Izzudinwahid/PT.MGI-DAS-POWER/DAS POWER/List Komponen Das Power.xlsx

KEPERLUAN DAS POWER UNTUK 1 UNIT
No | Nama Komponen | jumlah | Harga | ongkir | Total | keterangan | Link
1 | usb micro Connector | 2 | Rp 500 | Rp 7000 | Rp 8000 | Komponen yang sudah embbed di china(TIDAK PERLU DIORDER) | https://www.tokopedia.com/best-ay/micro-usb-5-pin-female-soket-socket-mk5p-5pin-connector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
2 | ch340g | 1 | Rp 6000 | Rp 7000 | Rp 13000 |  | https://www.tokopedia.com/isee/ic-ch340-ch340g-usb-serial-ttl-uart-rs232-chip-ch-340-sop-16-sop16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
3 | resistor 10k 0805 | 10 | Rp 100 |  | Rp 1000 |  | https://www.tokopedia.com/isee/resistor-smd-0805-10k-10-k-kilo-ohm-10000-ohm-toleransi-1-tolerance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
4 | ams1117 3.3V | 2 | Rp 1000 |  | Rp 2000 |  | https://www.tokopedia.com/isee/ams1117-3-3v-smd-regulator-sot-223?extParam=whid%3D318325
5 | resistor 330 0805 | 8 | Rp 100 |  | Rp 800 |  | https://www.tokopedia.com/isee/resistor-smd-0805-330ohm-330-ohm-toleransi-1-tolerance-1?extParam=whid%3D318325
6 | led SMD hijau | 3 | Rp 1000 |  | Rp 3000 |  | https://www.tokopedia.com/isee/10x-led-smd-0805-hb19-super-bright-2hb0756-terang-warna-hijau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
7 | crystal 12Mhz smd | 1 | Rp 3050 | Rp 7000 | Rp 10050 |  | https://www.tokopedia.com/digiware/12mhz-crystal-xtal-oscillator-osilator-low-profile-smd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
8 | capasitor 22pF 0805 | 5 | Rp 220 |  | Rp 1100 |  | https://www.tokopedia.com/digiware/22pf-50v-5-capacitor-kapasitor-smd-0805?extParam=whid%3D264299
9 | capasitor 1uF 0805 | 8 | Rp 300 | Rp 16000 | Rp 18400 |  | https://www.tokopedia.com/putraniagabdg/kapasitor-smd-0805-1uf-50v-capacitor-non-polar-105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
10 | capasitor elco 10uF/16V | 2 | Rp 800 |  | Rp 1600 |  | https://www.tokopedia.com/putraniagabdg/elco-smd-10uf-16v-alumunium-10-uf-16volt-aluminum-kapasitor-4x5-mm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
11 | resistor 100 ohm 0805 | 10 | Rp 1000 |  | Rp 10000 |  | https://www.tokopedia.com/putraniagabdg/10pcs-resistor-smd-0805-100r-tahanan-100-ohm-100ohm-marking-101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
12 | resistor 160 ohm 0805 | 10 | Rp 3000 | Rp 13000 | Rp 43000 |  | https://www.tokopedia.com/indo-ware/160r-160-ohm-0805-5-paket-10-pcs-resistor-smd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
13 | capasitor 100nF 0805 | 8 | Rp 600 |  | Rp 4800 |  | https://www.tokopedia.com/indo-ware/0805-104-100nf-100nf-50v-kapasitor-2012-104k-smd-kapasitor-capasitor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
14 | diode zener 3v3 smd | 8 | Rp 500 |  | Rp 4000 |  | https://www.tokopedia.com/indo-ware/33v-dioda-zener-05w-diode-3v3-33v-33-33-v-12w-12-05-05-w-smd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
15 | transistor MMBT3904 | 5 | Rp 100 | Rp 12000 | Rp 12500 |  | https://www.tokopedia.com/lisuinstrument/mmbt3904-3904-1am-2n3904-npn-general-purpose-transistor-sot-23-generic-biasa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
16 | schottky 1N5819 | 5 | Rp 200 |  | Rp 1000 |  | https://www.tokopedia.com/lisuinstrument/1n5819-sma-ss14-smd-1-0a-schottky-barrier-rectifier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
17 | TTL ke RS485 | 3 | Rp 15000 | Rp 7000 | Rp 52000 |  | https://www.tokopedia.com/akhishop/uart-ttl-to-rs485-module-two-way-converter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
18 | mini 560 5V | 1 | Rp 15000 |  | Rp 15000 |  | https://www.tokopedia.com/akhishop/dc-dc-mini560-5a-dc-stepdown-regulated-power-supply-module-5v
19 | mini W5500 | 1 | Rp 80000 |  | Rp 80000 |  | https://www.tokopedia.com/akhishop/mini-w5500-spi-to-lan-module?extParam=ivf%3Dfalse%26src%3Dsearch
20 | pzem 017 DC | 3 | Rp 150000 |  | Rp 450000 |  | https://www.tokopedia.com/akhishop/pzem-017-0-300v-rs485-modbus-dc-meter-current-voltage-power-energy-50a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
21 | ADS1115 | 3 | Rp 80000 |  | Rp 240000 |  | https://www.tokopedia.com/akhishop/ads1115-16-bit-adc-4-channel-with-programmable-gain-amplifier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
22 | lcd 20x4 i2c | 1 | Rp 70000 |  | Rp 70000 | beli 1 untuk ujicoba | https://www.tokopedia.com/akhishop/lcd-20x4-green-backlight-with-i2c-module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
23 | terminal block hijau 6p | 2 | Rp 9600 | Rp 20000 | Rp 39200 |  | https://www.tokopedia.com/s3-satriasecure/l-siku-pluggable-6-p-pin-terminal-blok-6p-6pin-screw-plugable-block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
24 | terminal block hijau 2p | 6 | Rp 3600 |  | Rp 21600 |  | https://www.tokopedia.com/s3-satriasecure/l-siku-pluggable-2-p-pin-5-08-terminal-2p-2pin-screw-plug-able-pcb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
25 | terminal block hijau 9p | 1 | Rp 12700 |  | Rp 12700 |  | https://www.tokopedia.com/s3-satriasecure/l-siku-pluggable-9-p-pin-terminal-blok-9p-9pin-screw-plugable-block
26 | push button L | 2 |  |  | Rp 0
27 | ESP32ESP32-WROOM-32D | 1 | Rp 39000 | Rp 21000 | Rp 60000 | TIDAK PERLU DIORDER | https://www.tokopedia.com/sagaladijualcorp/new-version-esp32-wroom-32d-wi-fi-bt-ble-32mbits-4mb-flash-espressif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
28 | adaptor 12v 2A | 1 | Rp 21000 | Rp 7000 | Rp 28000 |  | https://www.tokopedia.com/pusataccgadget/adaptor-charger-cctv-12v-2a-harga-khusus-dus-satuan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
29 | kabel serabut warna Merah | 1 | Rp 1200 | Rp 10000 | Rp 11200 |  | https://www.tokopedia.com/mulsanne/eceran-per-meter-kabel-tunggal-serabut-putih-merah?extParam=whid%3D3990461
30 | kabel serabut warna hitam | 1 | Rp 1200 |  | Rp 1200 |  | https://www.tokopedia.com/mulsanne/eceran-per-meter-kabel-tunggal-serabut-putih-hitam?extParam=whid%3D3990461
31 | kabel serabut warna hijau | 1 | Rp 1200 |  | Rp 1200 |  | https://www.tokopedia.com/mulsanne/eceran-per-meter-kabel-tunggal-serabut-putih-hijau-muda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
32 | kabel serabut warna kuning | 1 | Rp 1200 |  | Rp 1200 |  | https://www.tokopedia.com/mulsanne/eceran-per-meter-kabel-tunggal-serabut-putih-kuning?extParam=whid%3D3990461
33 | konektor xh 4pin | 2 | Rp 1600 | Rp 7000 | Rp 10200 |  | https://www.tokopedia.com/gst-21/konektor-molex-2-3-4-5-6-pin-soket-socket-molek-pitch-2-5-ph-jst-xh-4-pin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
34 | hall efect sensor for DC current measuring 100A | 3 | Rp 440000 | Rp 25000 | Rp 1345000 | Beli 3 dan Segera diorder karena pre-order | https://www.tokopedia.com/fadalstore/ankerui-ahkc-eka-0-100-a-5v-20-hall-open-type-current-sensor
35 | Oled i2c | 1 | Rp 38000 | Rp 10000 | Rp 48000 | beli 1 untuk ujicoba | https://www.tokopedia.com/hwthinker/modul-display-oled-128x64-lcd-i2c-0-96-inch-arduino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
TOTAL |  |  |  |  | Rp 2620750
Note:
1. Belum Termasuk PCB
2. Belum Termasuk Box
Penjelasan Warna:
 | segera diorder
 | Komponen Embbed di China
