Izzudinwahid/PT.MGI-DAS-POWER/DAS POWER/PCB/untitled.pdf

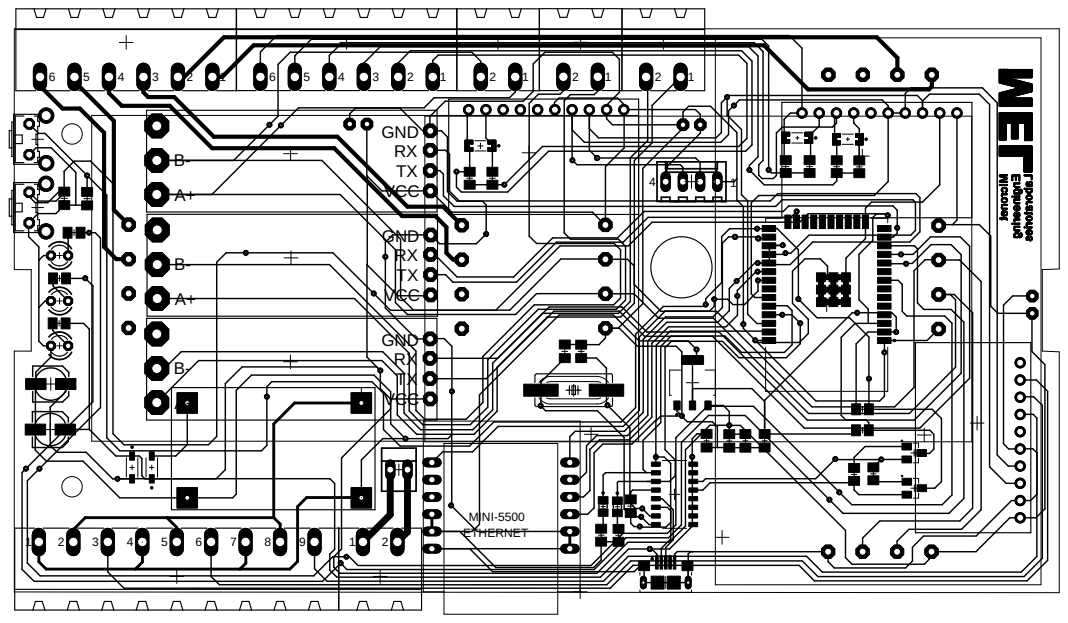
[picture p1: page 1]
