Izzudinwahid/PT.MGI-DAS-POWER/DAS POWER/PCB/untitled.brd

## EAGLE design DAS POWER/PCB/untitled.brd (2023-05-26)

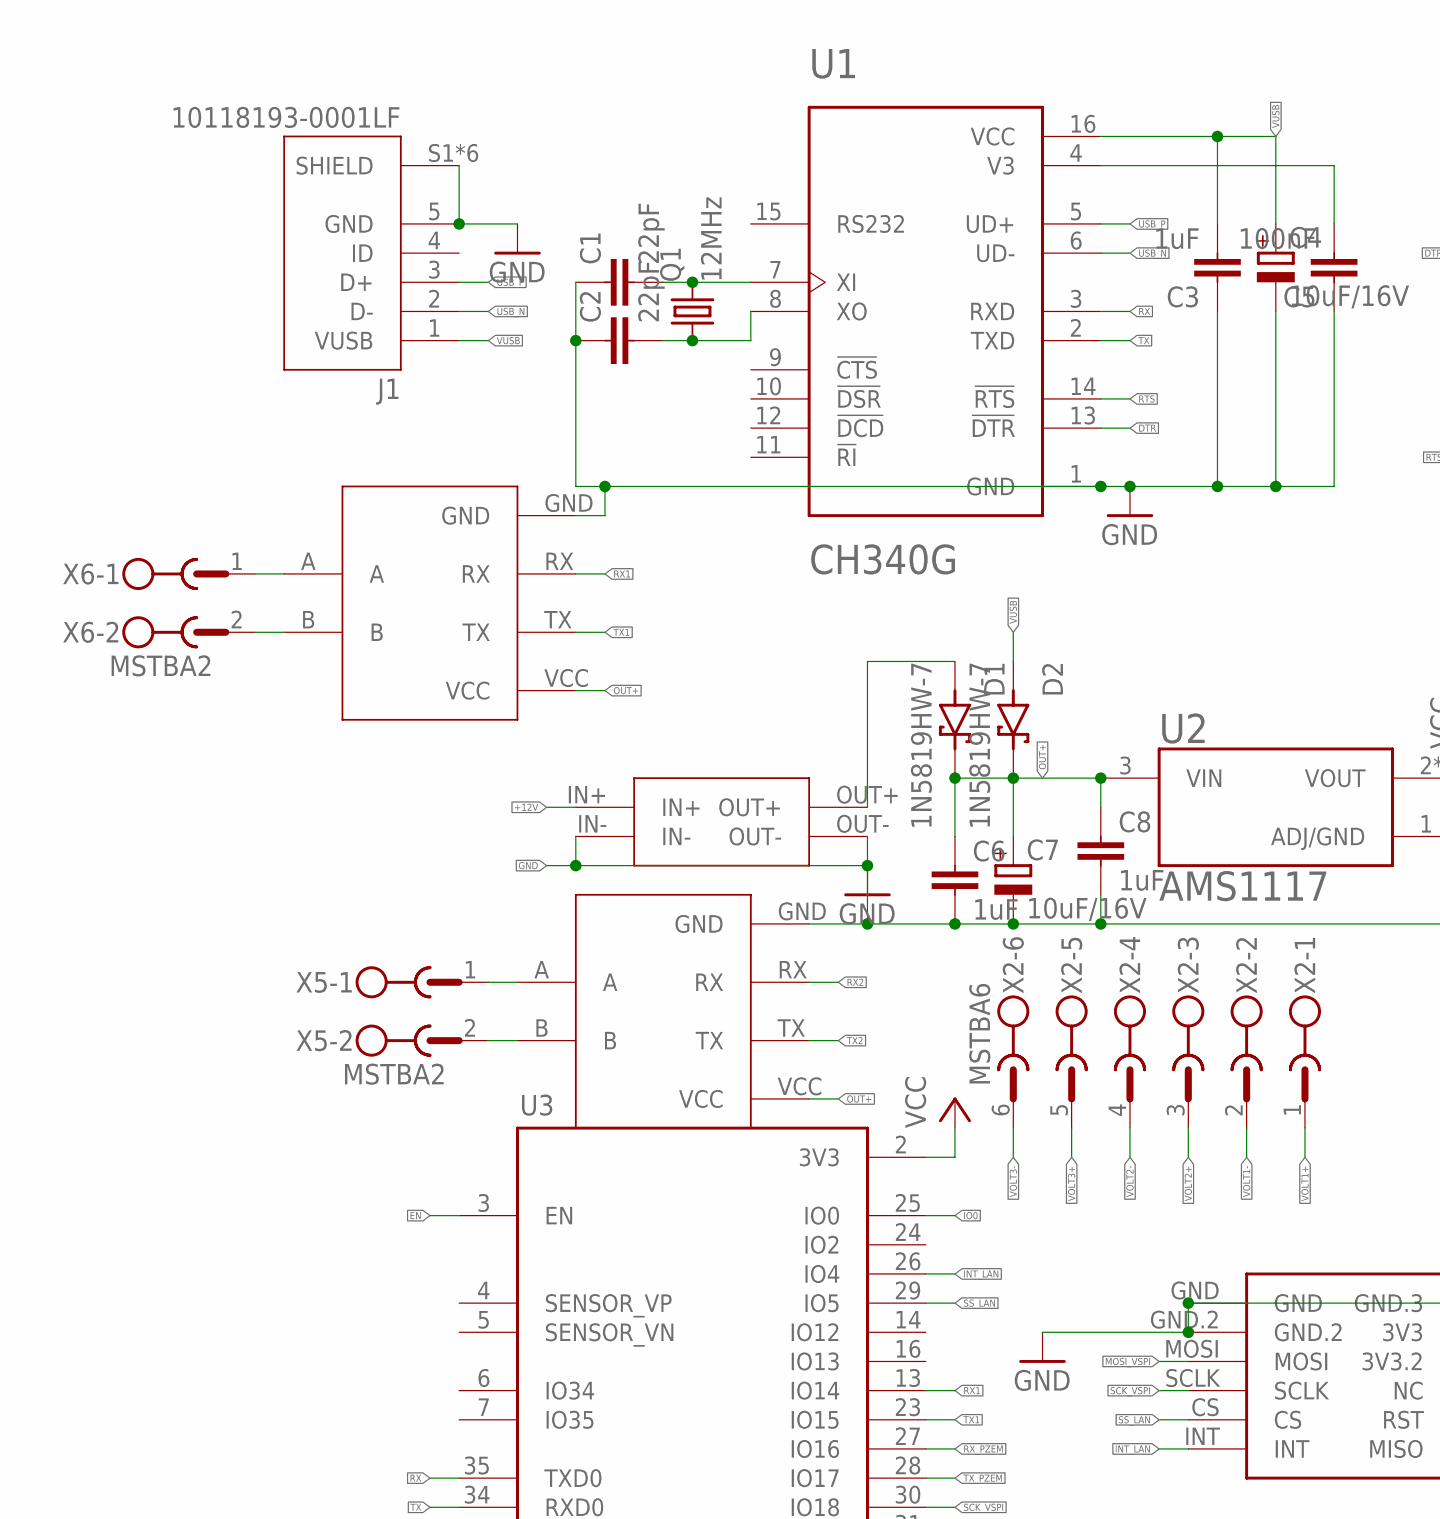
[picture p2: schematic untitled.sch, part in row 1, column 1]

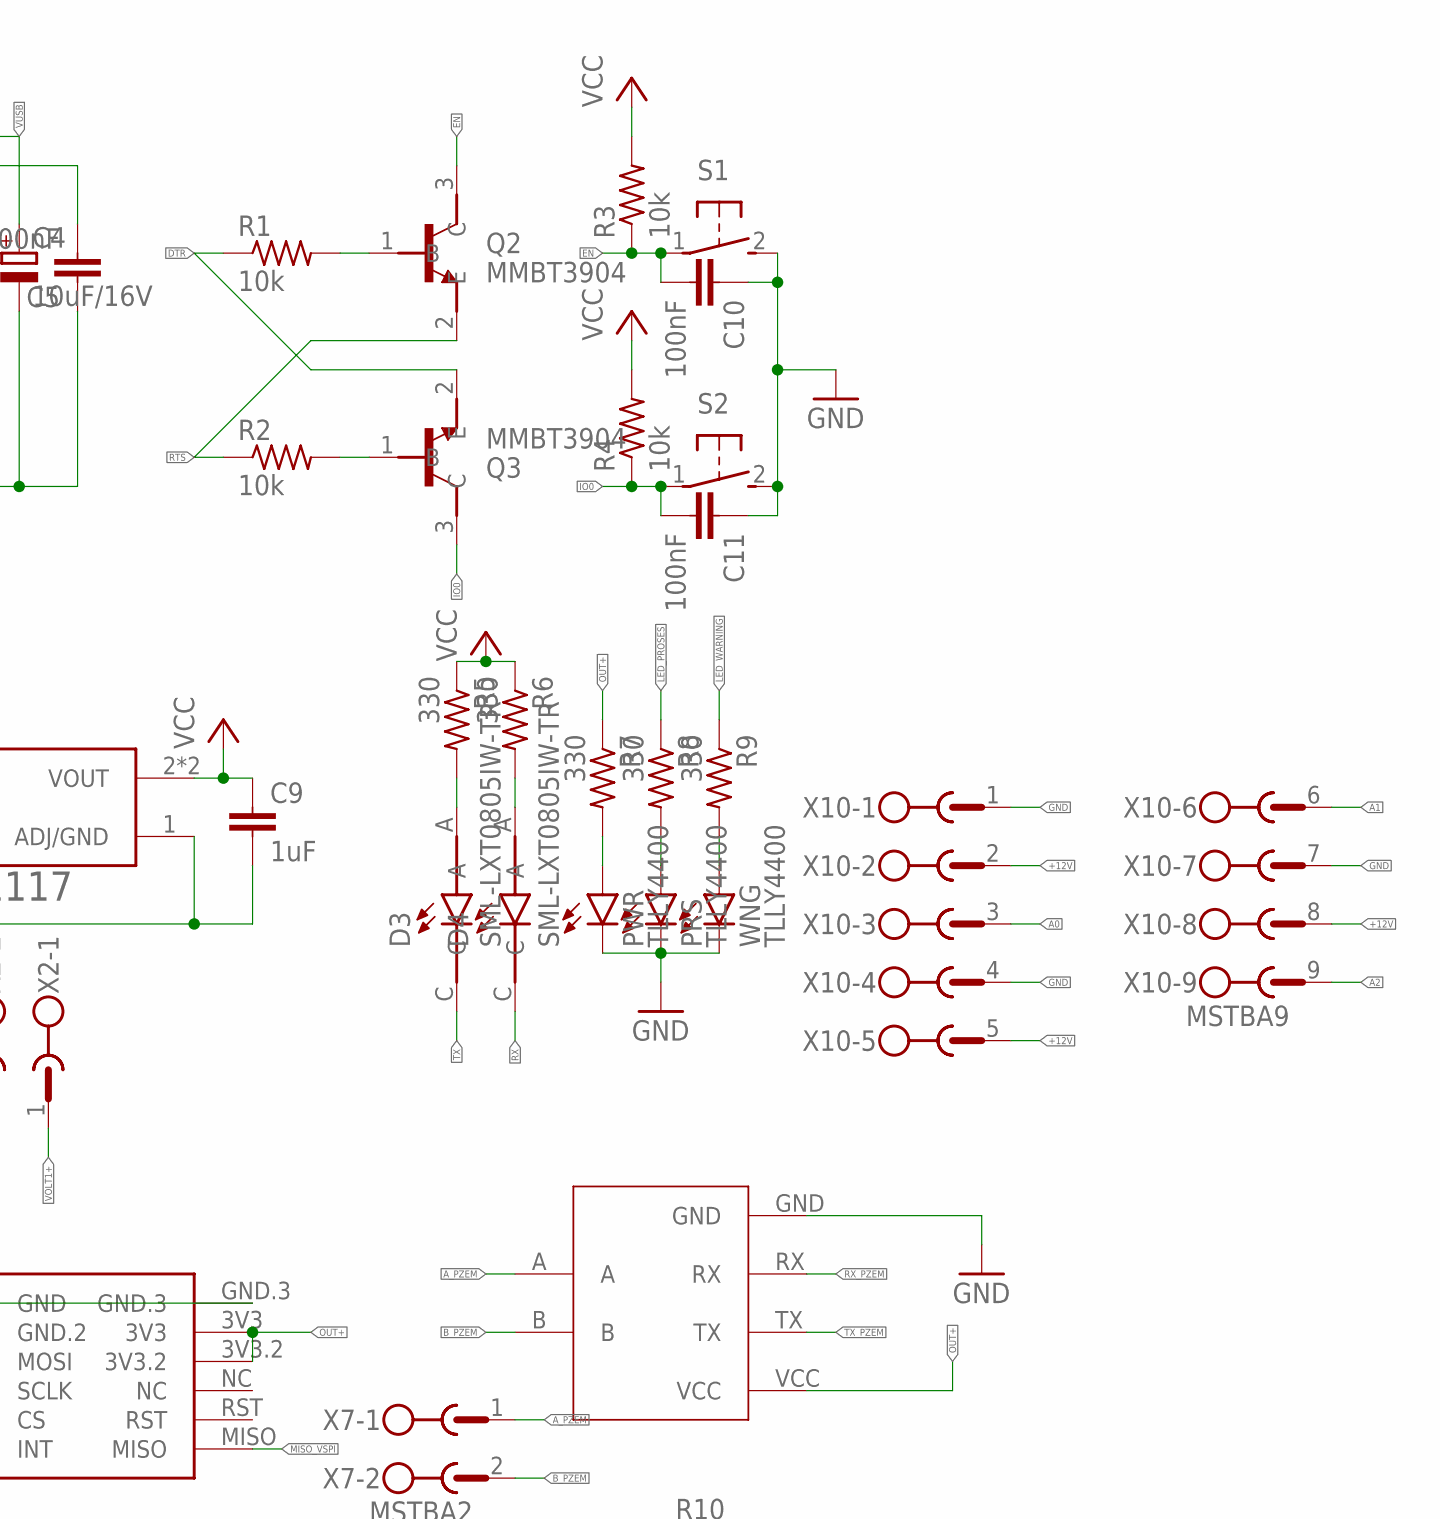
[picture p3: schematic untitled.sch, part in row 1, column 2]

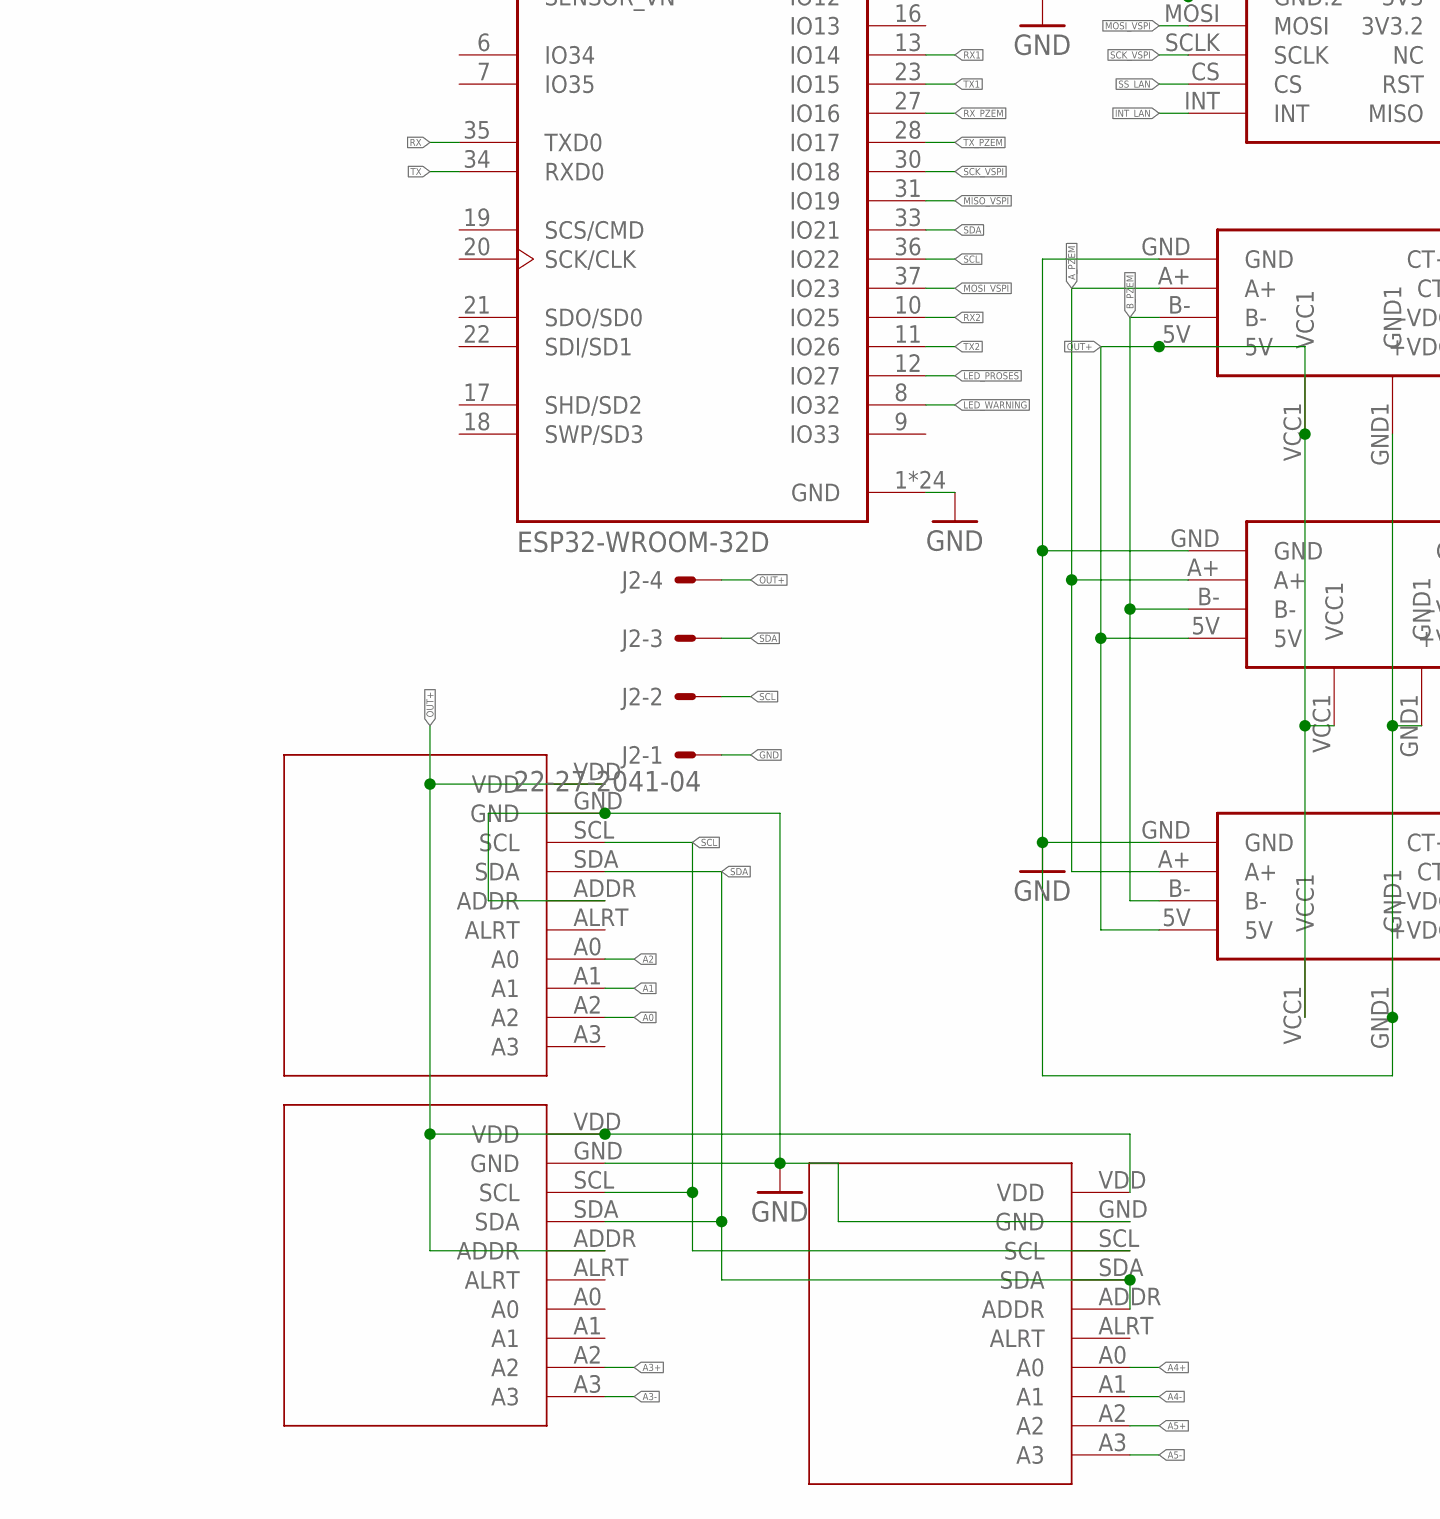
[picture p4: schematic untitled.sch, part in row 2, column 1]

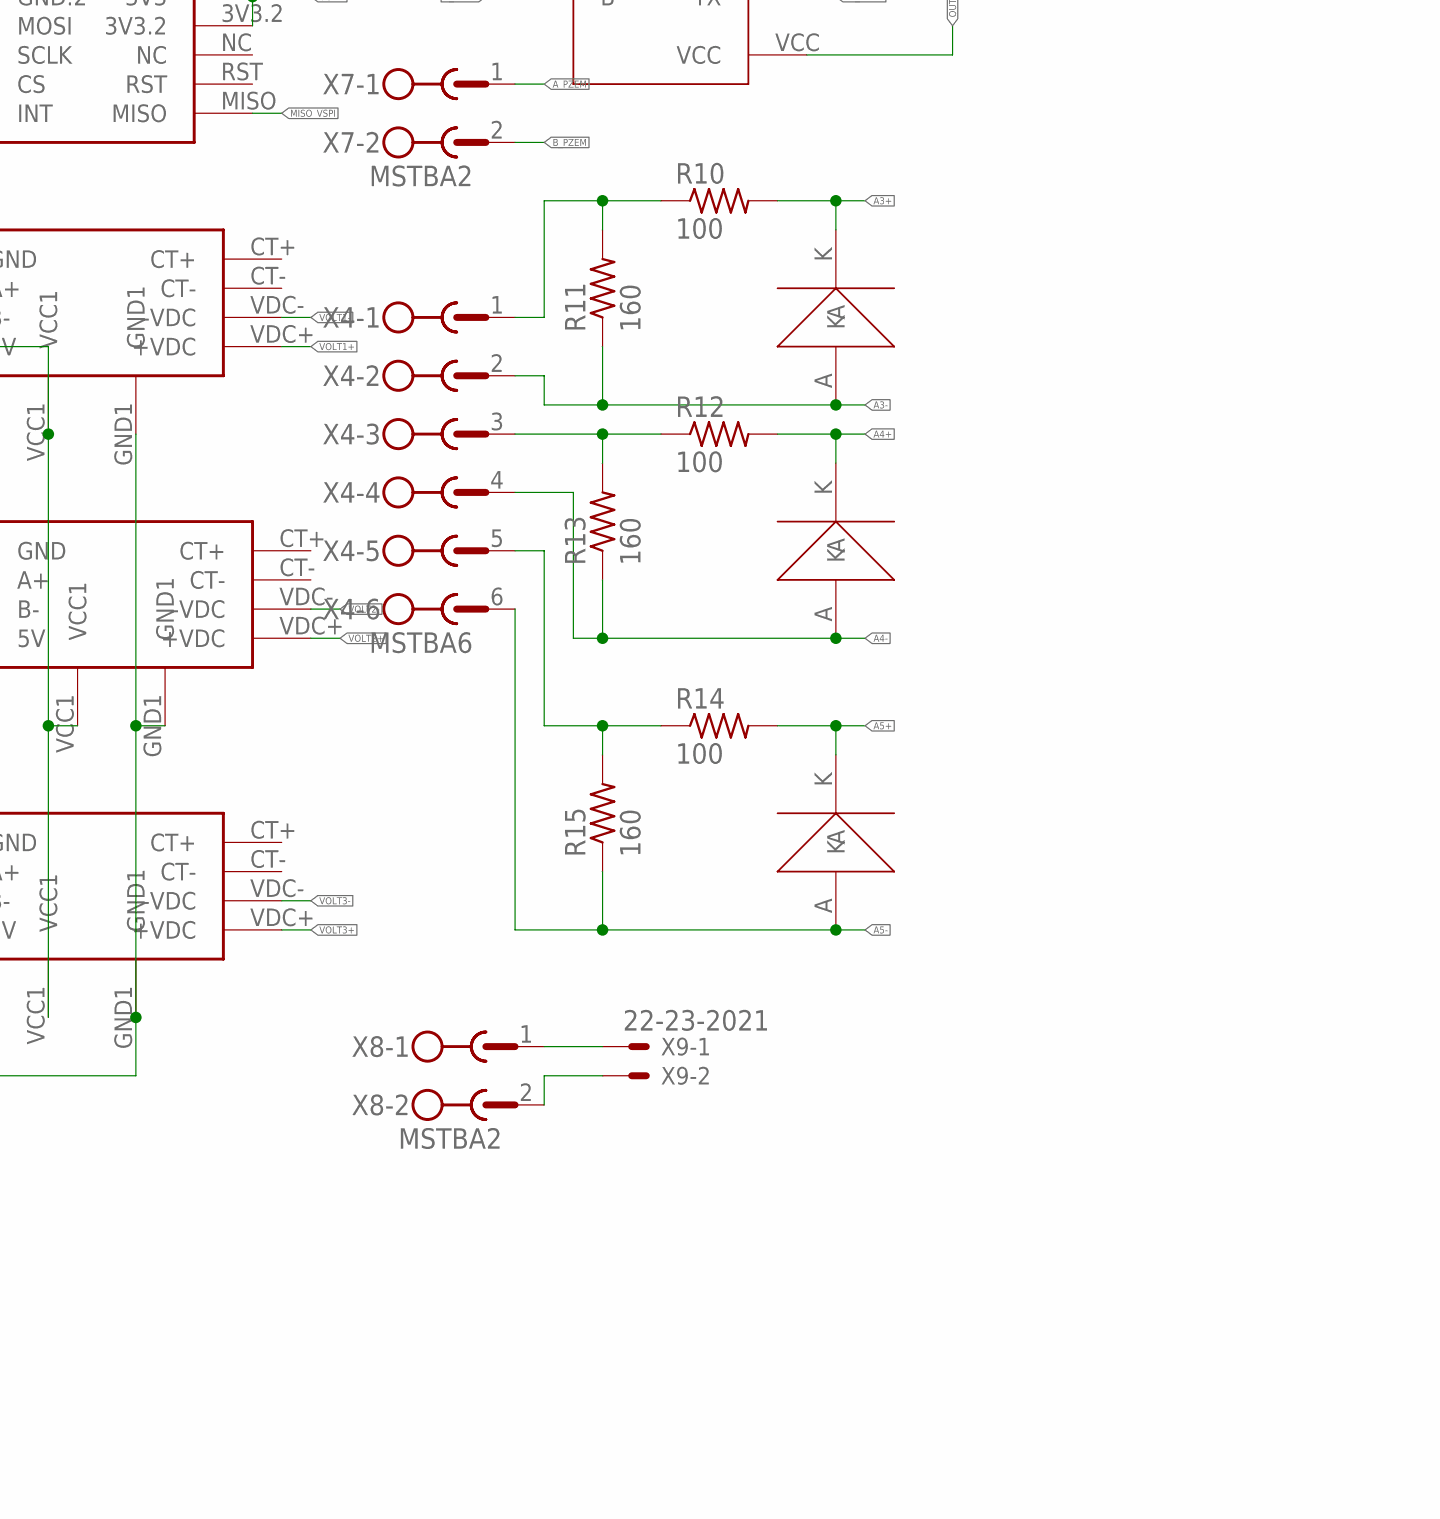
[picture p5: schematic untitled.sch, part in row 2, column 2]

Parts:
ADS1, ADS2, ADS3: ADS1115
C1, C2: 22pF; C0805K
C3, C6, C8, C9: 1uF; C0805K
C4, C7: 10uF/16V; 153CLV-0505
C5, C10, C11: 100nF; C0805K
D1, D2: 1N5819HW-7; SOD3715X145N
D3, D4: SML-LXT0805IW-TR; LEDC2012X120N
J1: 10118193-0001LF; FCI_10118193-0001LF
J2: 22-27-2041-04; 6410-04
MINI1: MINI560
PRS: TLLY4400; LED3MM
PWR: TLLY4400; LED3MM
PZEM-DC1, PZEM-DC2, PZEM-DC3: PZEM-DC
Q1: 12MHz; SM49
Q2, Q3: MMBT3904; SOT95P240X120-3N
R1, R2, R3, R4: 10k; M0805
R5, R6, R7, R8, R9: 330; M0805
R10, R12, R14: 100; M0805
R11, R13, R15: 160; M0805
S1, S2: 31-XX; B3F-31XX
TTL-RS1, TTL-RS2, TTL-RS3: TTL-RS485
U1: CH340G; SOIC127P600X180-16N
U2: AMS1117; SOT229P700X180-4N
U3: ESP32-WROOM-32D; MODULE_ESP32-WROOM-32D
U$1: MINI_W5500
WNG: TLLY4400; LED3MM
X2, X4: MSTBA6
X5, X6, X7, X8: MSTBA2
X9: 22-23-2021
X10: MSTBA9
ZENER3V1: 3v3; DIO_LL4148
ZENER3V2, ZENER3V3: ZENER3V3; DIO_LL4148

Connections:
+12V: MINI1.IN+, X10.2, X10.5, X10.8
A0: ADS1.A2, X10.3
A1: ADS1.A1, X10.6
A2: ADS1.A0, X10.9
A3+: ADS2.A2, R10.2, ZENER3V1.K
A3-: ADS2.A3, R11.1, X4.2, ZENER3V1.A
A4+: ADS3.A0, R12.2, ZENER3V2.K
A4-: ADS3.A1, R13.1, X4.4, ZENER3V2.A
A5+: ADS3.A2, R14.2, ZENER3V3.K
A5-: ADS3.A3, R15.1, X4.6, ZENER3V3.A
A_PZEM: PZEM-DC1.A+, PZEM-DC2.A+, PZEM-DC3.A+, TTL-RS1.A, X7.1
B_PZEM: PZEM-DC1.B-, PZEM-DC2.B-, PZEM-DC3.B-, TTL-RS1.B, X7.2
DTR: Q3.2 (E), R1.1, U1.13 (!DTR)
EN: C10.2, Q2.3 (C), R3.1, S1.1, U3.3 (EN)
GND: ADS1.ADDR, ADS1.GND, ADS2.GND, ADS3.GND, C1.1, C2.1, C3.1, C4.-, C5.1, C6.2, C7.-, C8.2, C9.2, C10.1, C11.1, J1.5 (GND), J1.S1 (SHIELD), J1.S2 (SHIELD), J1.S3 (SHIELD), J1.S4 (SHIELD), J1.S5 (SHIELD), J1.S6 (SHIELD), J2.1, MINI1.IN-, MINI1.OUT-, PRS.K (C), PWR.K (C), PZEM-DC1.GND, PZEM-DC1.GND1, PZEM-DC2.GND, PZEM-DC2.GND1, PZEM-DC3.GND, PZEM-DC3.GND1, S1.2 (S), S2.2 (S), TTL-RS1.GND, TTL-RS2.GND, TTL-RS3.GND, U1.1 (GND), U2.1 (ADJ/GND), U3.1 (GND), U3.15 (GND), U3.38 (GND), U3.39_1 (GND), U3.39_2 (GND), U3.39_3 (GND), U3.39_4 (GND), U3.39_5 (GND), U3.39_6 (GND), U3.39_7 (GND), U3.39_8 (GND), U3.39_9 (GND), U3.39_10 (GND), U3.39_11 (GND), U3.39_12 (GND), U3.39_13 (GND), U3.39_14 (GND), U3.39_15 (GND), U3.39_16 (GND), U3.39_17 (GND), U3.39_18 (GND), U3.39_19 (GND), U3.39_20 (GND), U3.39_21 (GND), U$1.GND, U$1.GND.2, U$1.GND.3, WNG.K (C), X10.1, X10.4, X10.7
INT_LAN: U3.26 (IO4), U$1.INT
IO0: C11.2, Q3.3 (C), R4.1, S2.1, U3.25 (IO0)
LED_PROSES: R8.1, U3.12 (IO27)
LED_WARNING: R9.1, U3.8 (IO32)
MISO_VSPI: U3.31 (IO19), U$1.MISO
MOSI_VSPI: U3.37 (IO23), U$1.MOSI
unnamed: C1.2, Q1.2, U1.7 (XI)
unnamed: C2.2, Q1.1, U1.8 (XO)
unnamed: C5.2, U1.4 (V3)
unnamed: Q2.1 (B), R1.2
unnamed: Q3.1 (B), R2.2
unnamed: D1.A, MINI1.OUT+
unnamed: R10.1, R11.2, X4.1
unnamed: D3.A, R5.2
unnamed: D4.A, R6.2
unnamed: PWR.A, R7.2
unnamed: PRS.A, R8.2
unnamed: R9.2, WNG.A
unnamed: TTL-RS2.A, X6.1
unnamed: TTL-RS2.B, X6.2
unnamed: X8.1, X9.1
unnamed: X8.2, X9.2
unnamed: R12.1, R13.2, X4.3
unnamed: TTL-RS3.A, X5.1
unnamed: TTL-RS3.B, X5.2
unnamed: R14.1, R15.2, X4.5
OUT+: ADS1.VDD, ADS2.ADDR, ADS2.VDD, ADS3.VDD, C6.1, C7.+, C8.1, D1.C (K), D2.C (K), J2.4, PZEM-DC1.5V, PZEM-DC1.VCC1, PZEM-DC2.5V, PZEM-DC2.VCC1, PZEM-DC3.5V, PZEM-DC3.VCC1, R7.1, TTL-RS1.VCC, TTL-RS2.VCC, TTL-RS3.VCC, U2.3 (VIN), U$1.3V3, U$1.3V3.2
RTS: Q2.2 (E), R2.1, U1.14 (!RTS)
RX: D4.C, U1.3 (RXD), U3.35 (TXD0)
RX1: TTL-RS2.RX, U3.13 (IO14)
RX2: TTL-RS3.RX, U3.10 (IO25)
RX_PZEM: TTL-RS1.RX, U3.27 (IO16)
SCK_VSPI: U3.30 (IO18), U$1.SCLK
SCL: ADS1.SCL, ADS2.SCL, ADS3.SCL, J2.2, U3.36 (IO22)
SDA: ADS1.SDA, ADS2.SDA, ADS3.ADDR, ADS3.SDA, J2.3, U3.33 (IO21)
SS_LAN: U3.29 (IO5), U$1.CS
TX: D3.C, U1.2 (TXD), U3.34 (RXD0)
TX1: TTL-RS2.TX, U3.23 (IO15)
TX2: TTL-RS3.TX, U3.11 (IO26)
TX_PZEM: TTL-RS1.TX, U3.28 (IO17)
USB_N: J1.2 (D-), U1.6 (UD-)
USB_P: J1.3 (D+), U1.5 (UD+)
VCC: C9.1, R3.2, R4.2, R5.1, R6.1, U2.2 (VOUT), U2.4 (VOUT), U3.2 (3V3)
VOLT1+: PZEM-DC1.VDC+ (+VDC), X2.1
VOLT1-: PZEM-DC1.VDC- (-VDC), X2.2
VOLT2+: PZEM-DC2.VDC+ (+VDC), X2.3
VOLT2-: PZEM-DC2.VDC- (-VDC), X2.4
VOLT3+: PZEM-DC3.VDC+ (+VDC), X2.5
VOLT3-: PZEM-DC3.VDC- (-VDC), X2.6
VUSB: C3.2, C4.+, D2.A, J1.1 (VUSB), U1.16 (VCC)

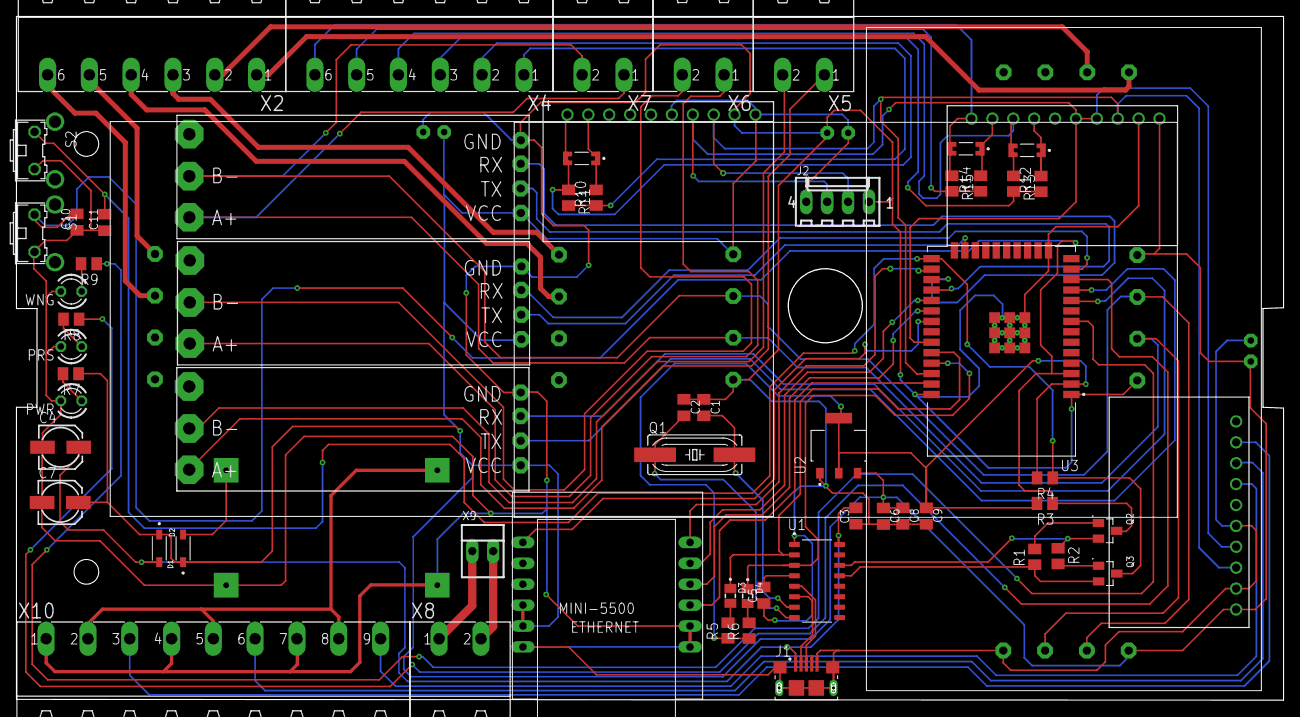
[picture p6: board untitled.brd from above]

Board: 2 copper layers, 154.0 x 83.1 mm, 65 parts (1 on the bottom side), 65 nets.
