Izzudinwahid/PT.MGI-DAS-POWER/(commit log)

2023-02-16 Das Power 16/02/2023
    [List Komponen Das Power.xlsx, untitled.brd, untitled.sch]
2023-02-21 revisi final tanggal 21/02.2023
    [List Komponen Das Power.xlsx, untitled.brd, untitled.sch, untitled_bom.csv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]
2023-05-26 PCB DAS POWER
    [untitled.brd, untitled.sch]
2023-05-31 fix PCB
